nickfrey/BC-transit-tracker/README.md

# Transit Tracker

Please see the complete documentation [here](https://eastsideurbanism.github.io/transit-tracker)!
