nickfrey/BC-transit-tracker/docs/static/frame/transit-tracker-frame.step

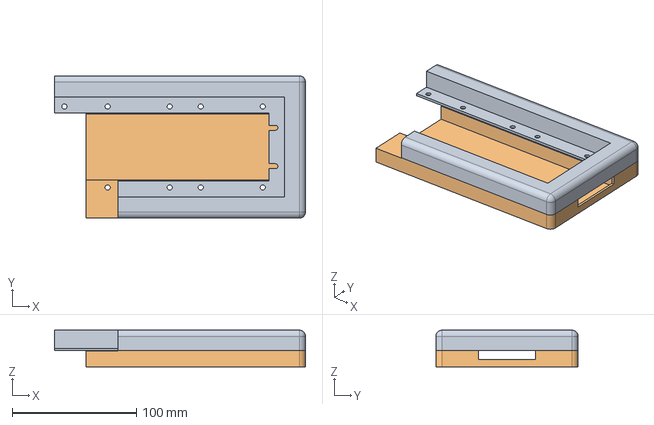
[picture p1: CAD file, 2025-02-07]
docs/static/frame/transit-tracker-frame.step
202.4 x 114.8 x 29.6 mm
Front
Back
