nickfrey/BC-transit-tracker/(list of files, cad)

Other CAD files:
docs/static/frame/transit-tracker-frame.stl
