nickfrey/BC-transit-tracker/docs/docs/02-user-manual/01-configuration/_img/route-editor.png

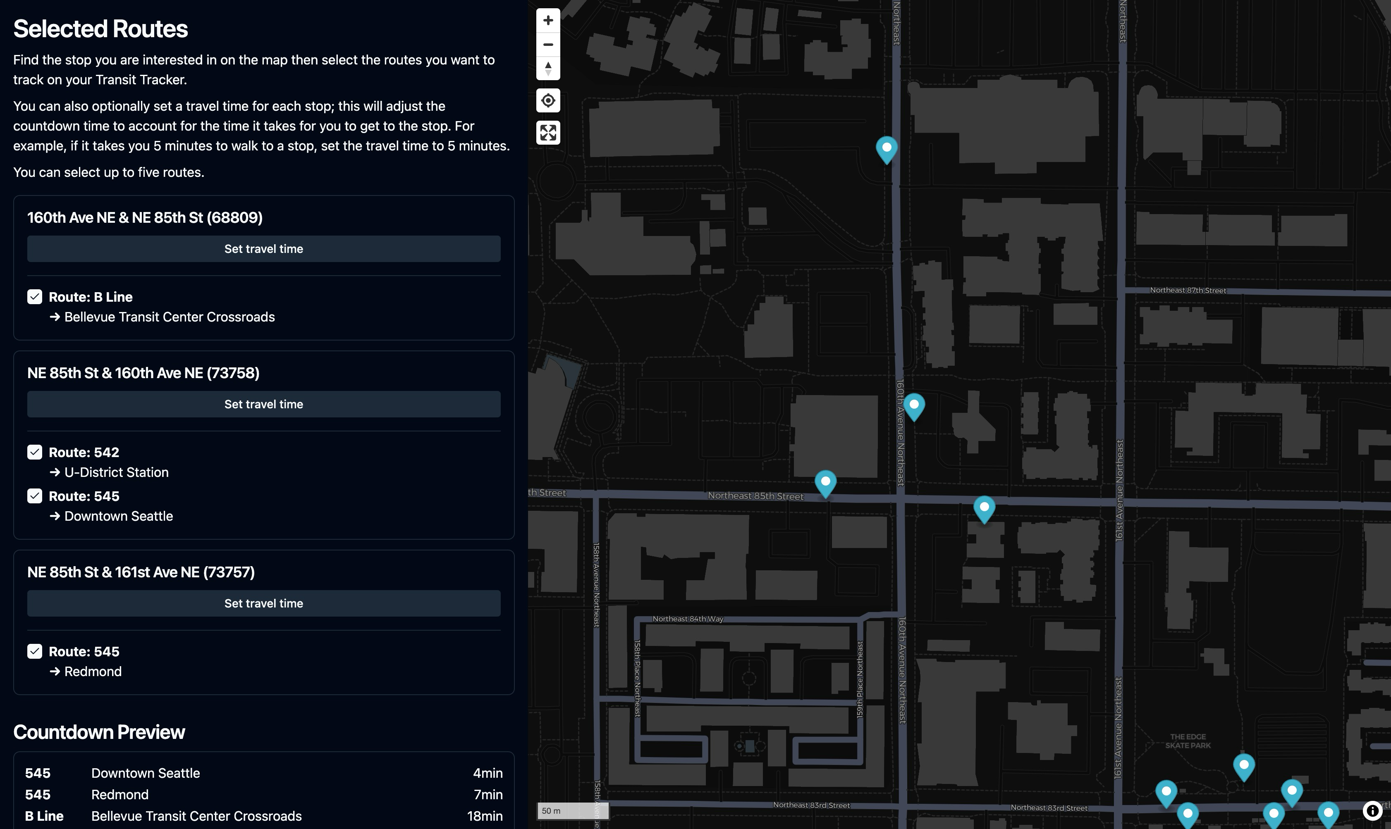
docs/docs/02-user-manual/01-configuration/_img/route-editor.png
