nickfrey/BC-transit-tracker/docs/docs/98-build-parties/_img/build-party.jpg

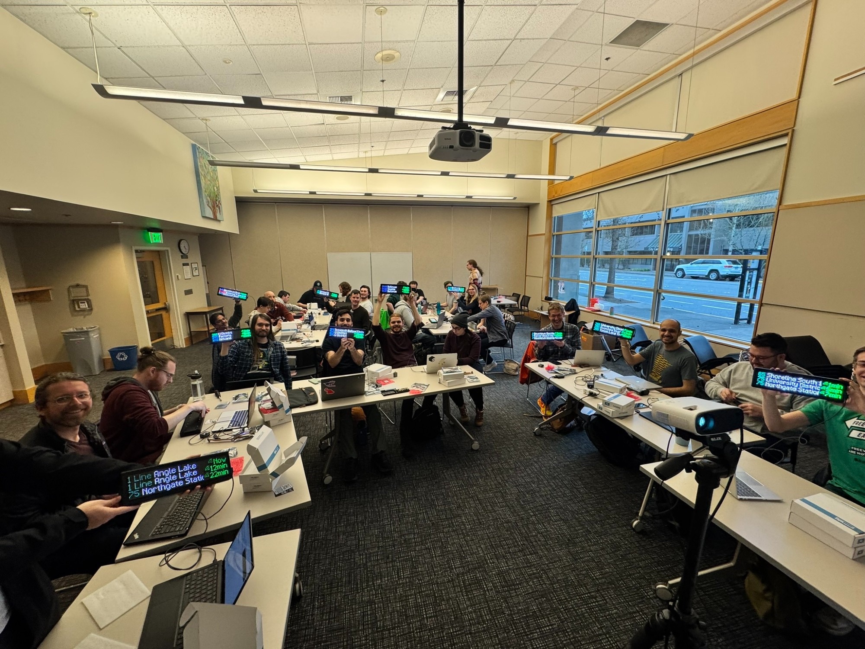
docs/docs/98-build-parties/_img/build-party.jpg
