nickfrey/BC-transit-tracker/docs/docs/02-user-manual/99-faq/_img/brightness-web-ui.png

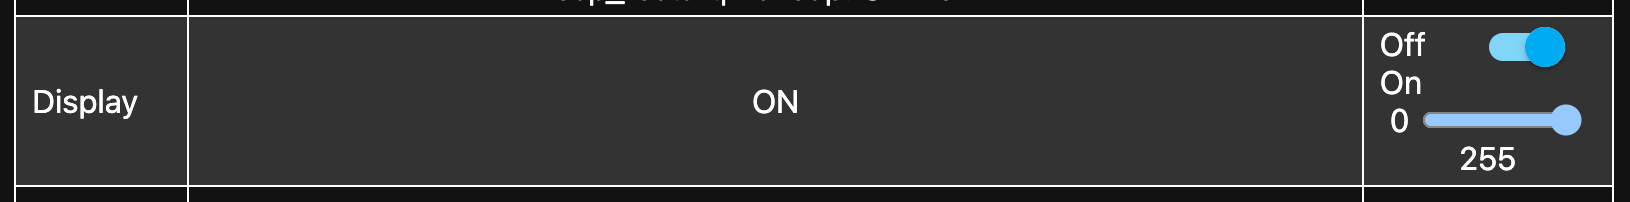
docs/docs/02-user-manual/99-faq/_img/brightness-web-ui.png
