nickfrey/BC-transit-tracker/(commit log)

2025-01-19 update guide with videos and photos
    [frame.stl]
2025-01-19 note about weather resistance
2025-01-23 frame with more tolerance
    [frame.stl]
2025-01-28 update frame, ESPHome config, font
    [frame.stl]
2025-01-28 reference the mounting holes
2025-01-28 update 3D printing guidance
2025-01-30 update frame model and add step file
    [frame.step, frame.stl]
2025-02-05 update to slimmer frame
    [frame.step, frame.stl]
2025-02-07 final version of frame
    [frame.step, frame.stl]
2025-03-13 new documentation site
    [frame.step, frame.stl]
2025-04-26 firmware: add config option for flip display
    [transit-tracker.yaml]
2025-04-26 firmware: swap brightness buttons when flipped
    [transit-tracker.yaml]
2025-05-02 fix buttons alignments on mobile
2025-05-22 ci: pin esphome version for font reasons
2025-06-19 rename frame files
    [transit-tracker-frame.step, transit-tracker-frame.stl]
2025-06-19 replace with printables link
2025-09-02 Fix colors on 64x64 displays
    [transit-tracker-64x64.yaml]
